wagiminator/CH32V003-NeoPixel-Pendant/hardware/NeoPendant_BOM.tsv

ID | Name | Designator | Footprint | Quantity | Manufacturer Part | Manufacturer | Supplier | Supplier Part
1 | LIR2032 | BAT | CR2032-SMD | 1
2 | 100n | C1 | C_0603 | 1 | CC0603KRX7R9BB104 | YAGEO | LCSC | C14663
3 | 10u | C2 | C_0603 | 1 | CL10A106KP8NNNC | SAMSUNG | LCSC | C19702
4 | SWIO | H1 | 210S-3X1/2.54/FLAT | 1 | Header2.54mm 1*3P | BOOMELE | LCSC | C49257
5 | WS2812-2020 | LED1,LED2,LED3,LED4,LED5,LED6,LED7,LED8,LED9,LED10,LED11,LED12,LED13,LED14,LED15,LED16 | WS2812-2020 | 16 | WS2812C-2020 | worldsemi | LCSC | C965556
6 | 330R | R1 | 0603 | 1 | 0603WAF3300T5E | UniOhm | LCSC | C23138
7 | POWER | SW1 | SW-SMD_SS-1290L-GLL-1.5MM | 1 | SS-1290L-GL L=1.5mm | RI SHENG | LCSC | C695418
8 | SET | SW2 | KEY-3.0*6.0 | 1 | 3x6x2.5Red head high temperature | ReliaPro | LCSC | C46491
9 | CH32V003J4M6 | U1 | SOP-8_150MIL | 1 | CH32V003J4M6 | WCH(Jiangsu Qin Heng) | LCSC | C5346354
