wagiminator/CH32V003-NeoPixel-Pendant/hardware/NeoPendant_schematic.pdf

3.7V Battery | Power Switch | Tactile Switch

## Microcontroller

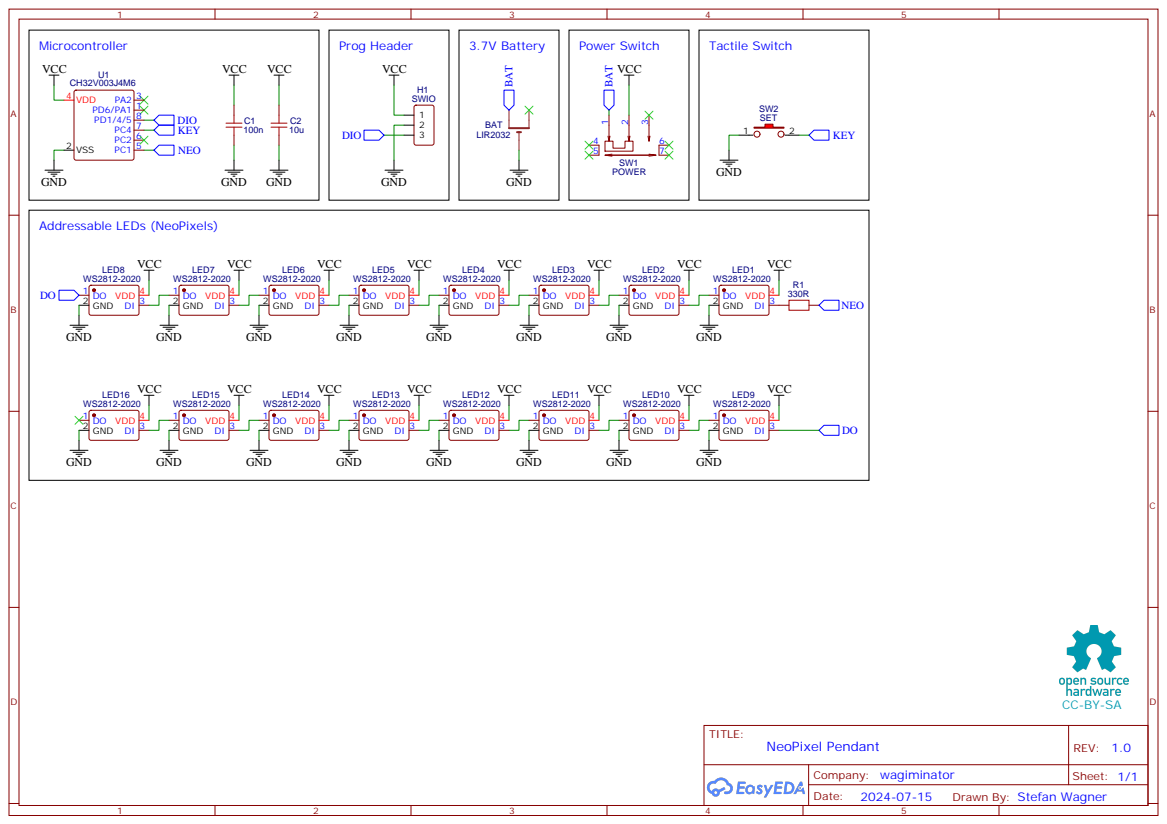
[picture p6: page 1]

Drawn By: Stefan Wagner
